KushlaVR/WemosRemote/WemosRemote/Receiver/data/html/pcb.jpg

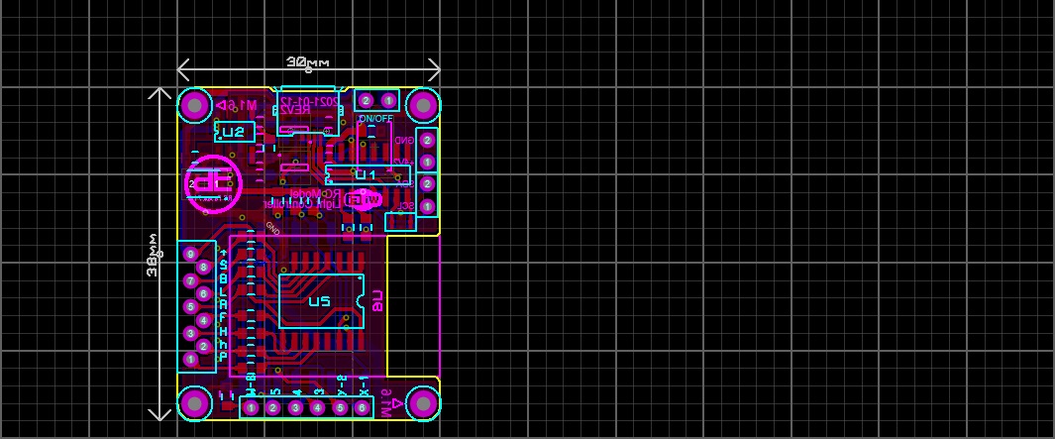
WemosRemote/Receiver/data/html/pcb.jpg
