KushlaVR/WemosRemote/tools/bottom - assembly.pdf

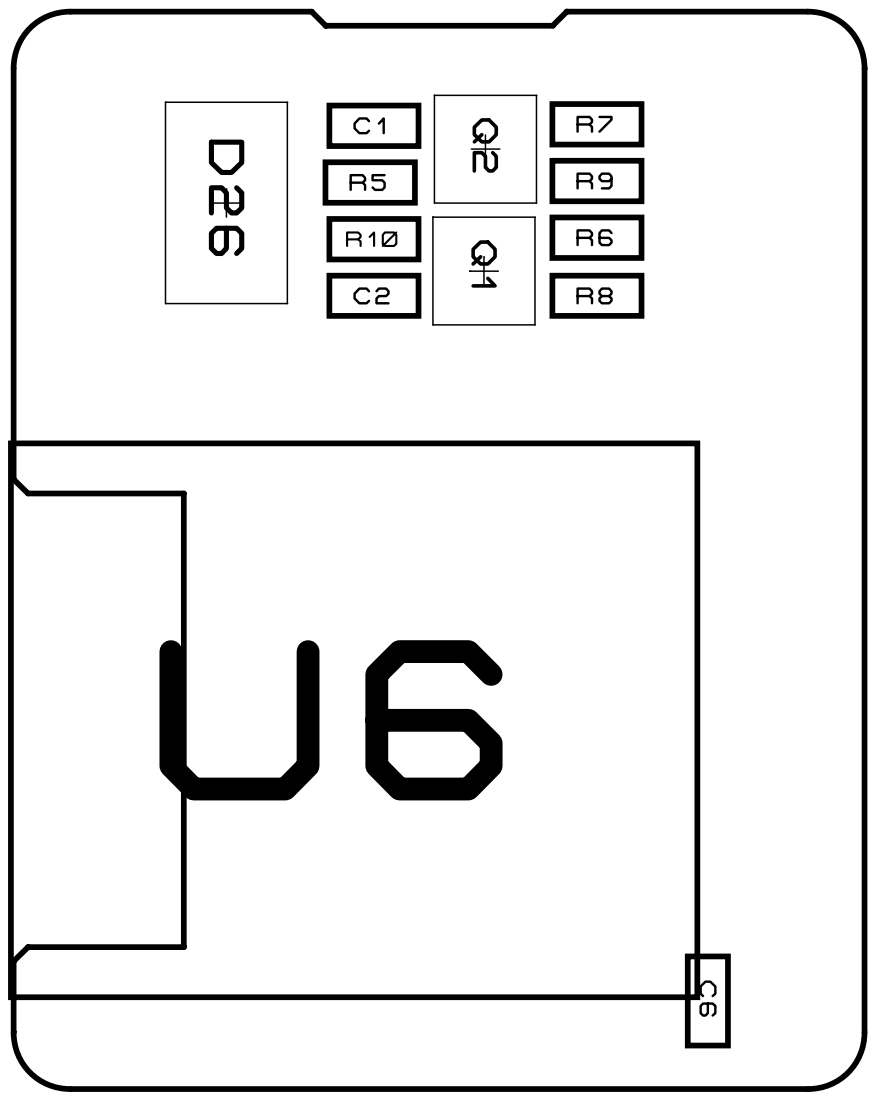
[picture p10: figure]
