KushlaVR/WemosRemote/tools/Bill Of Materials UAZ452.pdf

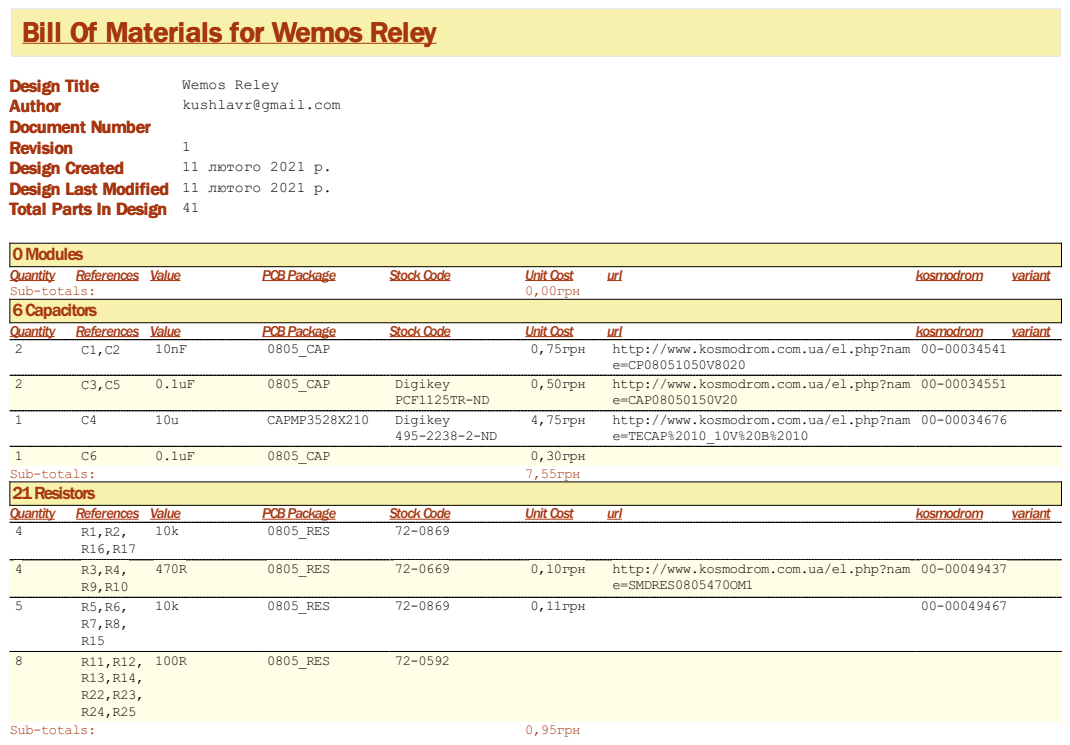
[picture p11: page 1]

Bill Of Materials for Wemos Reley

Document Number
Design Last Modified 11 лютого 2021 р.
Total Parts In Design 41

4 | R3,R4, | 470R | 0805_RES | 72-0669 | 0,10грн | http://www.kosmodrom.com.ua/el.php?nam | 00-00049437

R9,R10 | | | e=SMDRES0805470OM1

## 4Integrated Circuits

Quantity | References Value | PCBPackage | StockCode | Unit Cost | url | kosmodrom | variant
1 | U1 | CH340G | SO16 | 25,00грн
1 | U2 | KF33BD-TR | SO8 | 12,75грн | http://www.kosmodrom.com.ua/el.php?nam
| | | | | e=KF33BD-TR | 00-00026127
1 | U5 | PCF8574A | SO16W
1 | U6 | ESP-12 | ESP-12-S | 98,00грн | 00-00048613
Sub-totals: | 135,75грн

## 2Transistors

Quantity | References Value | PCBPackage | StockCode | Unit Cost | url | kosmodrom | variant
2 | Q1,Q2 | BC817-40 | SOT95P230X109-3 Digikey
| | | 497-2531-2-ND | 0,50грн | http://www.kosmodrom.com.ua/el.php?nam e=BC817-40.215 | 00-00031366
Sub-totals: | 1,00грн

## 1Diodes

Quantity | References Value | PCBPackage | StockCode | Unit Cost | url | kosmodrom | variant
1 | D26 | SM11 | DIOM5336X240 | Digikey
| | | MBRS3200T3GOSCT- ND | 9,25грн | http://www.kosmodrom.com.ua/el.php?nam e=MBRS3200T3G | 00-00033324
Sub-totals: | 9,25грн

## 7Miscellaneous

Quantity | References Value | PCBPackage | StockCode | Unit Cost | url | kosmodrom | variant
1 | J1 | CONN-SIL6 | CONN-SIL6
3 | J3,J4,J9 | CONN-SIL2 | CONN-SIL2
1 | J7 | USB B micro | USB B micro | 3,00грн | 00-00040869
1 | J8 | CONN-SIL9 | CONN-9-PIN
1 | Y1 | CSTCE12M0G55-
| R0 | CSTCE | Digikey 490-1197-1-ND | 9,00грн | http://www.kosmodrom.com.ua/el.php?nam e=CSTCE12M0G55-R0 | 00-00060512
Sub-totals: | 12,00грн
Totals: | | | | 166,50грн

10 березня 2021 р. 22:04:51
