KushlaVR/WemosRemote/tools/top - assembly.pdf

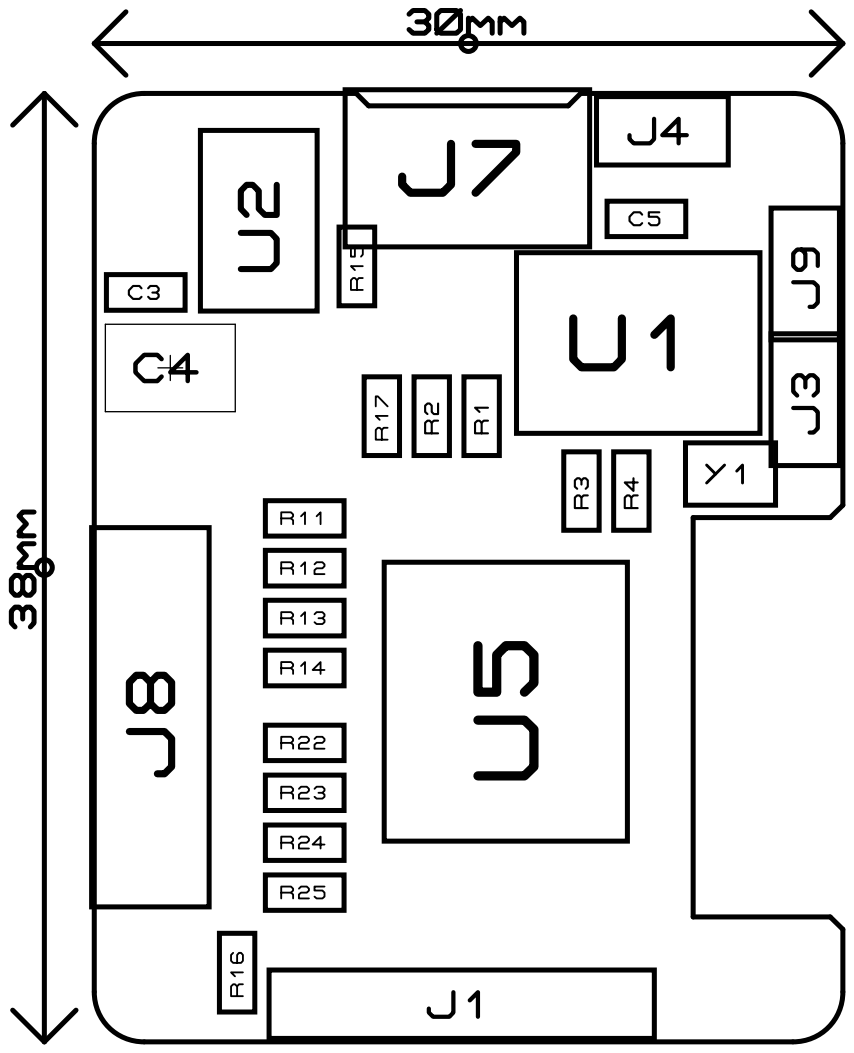
[picture p12: page 1]
