KushlaVR/WemosRemote/img/GAZ13.PDF

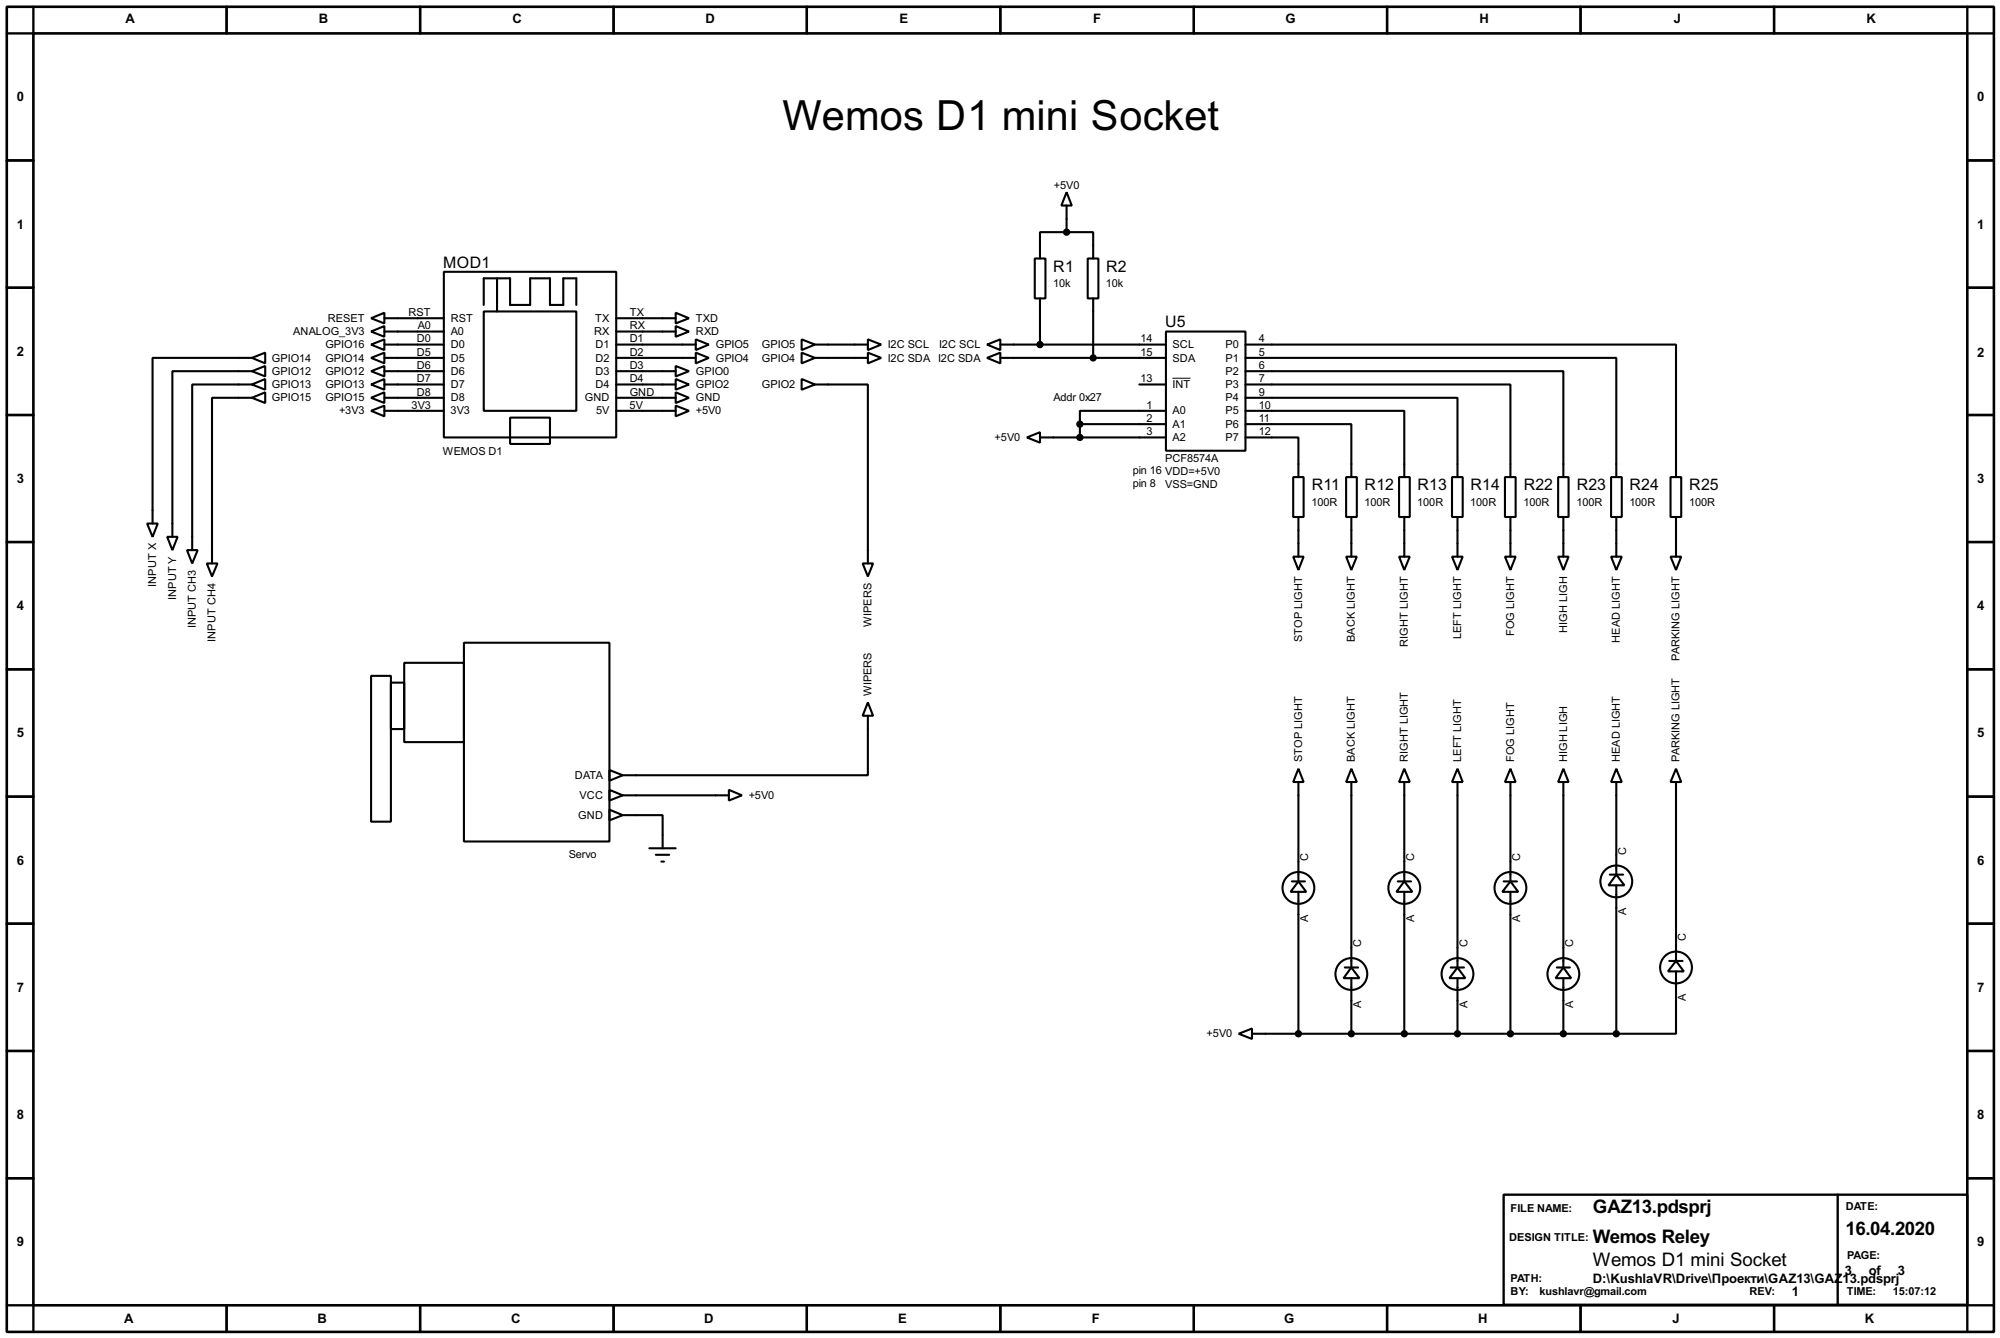
[picture p13: page 1]

DESIGN TITLE: Wemos Reley
