KushlaVR/WemosRemote/(list of files, drawings)

Other design files:
img/GAZ13.pdsprj
tools/uaz452-REV2.pdsprj
tools/uaz452-REV3.pdsprj
tools/uaz452-REV4.pdsprj
tools/uaz452.pdsprj
