KushlaVR/WemosRemote/(commit log)

2019-10-23 Додав вебортал для налаштування
2019-10-24 Доробив світло
2019-10-29 Add stearing motor
2019-11-01 Додав модуль налаштування
2019-11-01 Додав таймаут виключення заднього ходу
2019-11-01 Додав скрипт для поновлення
2019-11-03 Змінив алгоритм включення стопсигналу
2019-11-04 add backlight PWM setting
2019-11-09 Змінив алгоритм включенн світла
2019-11-09 Поновив прошивки в папці tools
2019-11-12 Вилічив серву від дригання, змінив налаштування світла
2019-11-13 Поправив баз зміни яскравості поворотників
2019-11-13 Поновив опис
2019-11-15 Добавив Біпер
2019-11-23 Додав вивід звуку на RX пін
2019-11-23 Додав настройки клаксона
2019-11-29 Update schematic
2019-12-09 додав опцію вибору контроллера
2019-12-10 Виправив помилку з відказом мотора
2020-02-09 Поновив прошивки
2020-02-09 update driver href
2020-03-13 Update README.md
    Виправив друкарські та граматичні помилки, узгодив відмінки, усталені абревіатури (ШИМ->ШІМ, стопсигнал->стоп-сигнал, WIFI->Wi-Fi)
2020-04-13 update files
    [GAZ13.pdsprj]
2020-04-15 add wipers handler
    [GAZ13.pdsprj]
2020-04-20 Додав опис
2020-04-20 Поновиви опис
2020-05-13 Fix wipers servo
2020-05-14 Розширив діапазон
2020-05-14 Додав варіант прошивки D0 (склоочистники на піні D0)
2021-03-11 test firmware
    [Bill Of Materials Wemos Reley.csv, GAZ13.pdsprj, bom.xlsx, uaz452-REV2.pdsprj, uaz452-REV3.pdsprj, uaz452.pdsprj]
2021-10-08 REV4 - fixed RX/TX
    [uaz452-REV3.pdsprj, uaz452-REV4.pdsprj]
